cmu-spacecraft-design-build-fly-2023/Ops-Groundstation/(commit log)

2023-09-04 Initial schematic design for RFM98 HAT
    [Radio HAT.kicad_sch]
2023-09-08 Finished schematic, started board layout
    [Radio HAT.kicad_pcb, Radio HAT.kicad_sch]
2023-09-08 Finished board design
    [Radio HAT.kicad_pcb, Radio HAT.kicad_sch]
2023-09-10 Implemented changes from PR review
    Changes implemented:
    - added schematic documentation and page settings
    - fixed PCB silkscreen
    - added board rev. and information on back silkscreen
    - added 3D models, generated 3D model for board
    - generated HTML BOM
    [Radio HAT.kicad_pcb, Radio HAT.kicad_sch, Radio HAT.step]
2023-09-11 Implemented changes from PR
    Fixed 3D models of board, added testpoints on board.
    [Radio HAT.kicad_pcb, Radio HAT.kicad_sch]
2023-09-11 Reworked GND stitching vias
    [Radio HAT.kicad_pcb]
2023-10-15 Changed connector orientation
    Changed orientation of 40-pin connector, increased board size, added optional pot, added graphics
    [Radio HAT.kicad_pcb, Radio HAT.kicad_sch]
2023-10-24 Implemented PR feedback by Jason
    [Radio HAT.kicad_pcb, Radio HAT.kicad_sch]
2023-10-25 Updated schematic, changed power routing
    [Radio HAT.kicad_pcb, Radio HAT.kicad_sch]
2023-10-29 Reworked power traces, added stitching vias
    Reworked 3V3 net, added stitching vias on board, added passive components, regenerated BOM and STEP file for board
    [Radio HAT.kicad_pcb, Radio HAT.kicad_sch]
2023-10-30 Updated copper pours
    Copper pours had gone out of alignment, reworked and increased sizes
    [Radio HAT.kicad_pcb, Radio HAT.kicad_sch]
2023-11-01 Converted to 4-layer board
    Changes:
    - added 2 internal layers
    - stackup: PWR - GND - SIG - GND
    - added POW indicator LED
    - increased density of stitching vias
    [Radio HAT.kicad_pcb, Radio HAT.kicad_sch]
2023-11-10 Radio HAT v1.1 redesign
    - Board is back to PWR-GND-SIG-GND
    - Made small electrical changes in a lot of spots with Jason
    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
    [Radio HAT.kicad_pcb, Radio HAT.kicad_sch]
2023-11-11 Impedance matched ANT trace
    [Radio HAT.kicad_pcb]
