cmu-spacecraft-design-build-fly-2023/Ops-Groundstation/(notices)

Notices in the files:
Radio HAT/Radio HAT.kicad_pcb:
LICENSE: CC BY 4.0
